panovvv/handmade-kicad-libraries/(commit log)

2020-03-27 Organize footprints
2020-04-11 KF141V-6P footprint
2020-04-13 Extended silkscreen for KF141V
